mehdidotesk73/3d-print-designs/src/dog_bag_dispenser/stl/dispenser_assembly.stl

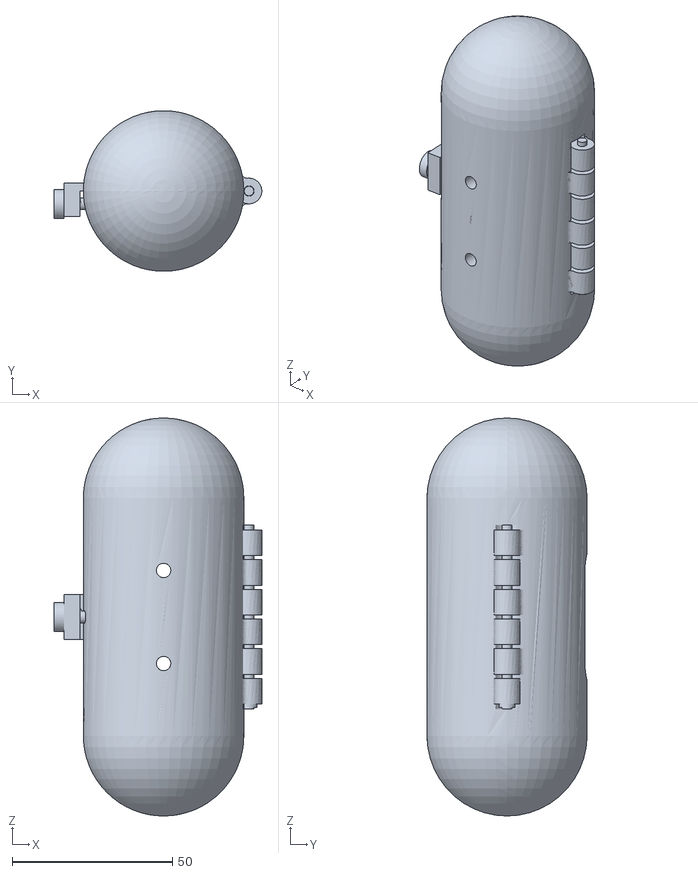
[picture p1: CAD file, 2026-09-21]
src/dog_bag_dispenser/stl/dispenser_assembly.stl
64.7 x 50.0 x 124.0
