mehdidotesk73/3d-print-designs/src/dog_bag_dispenser/stl/hinge_pin.stl

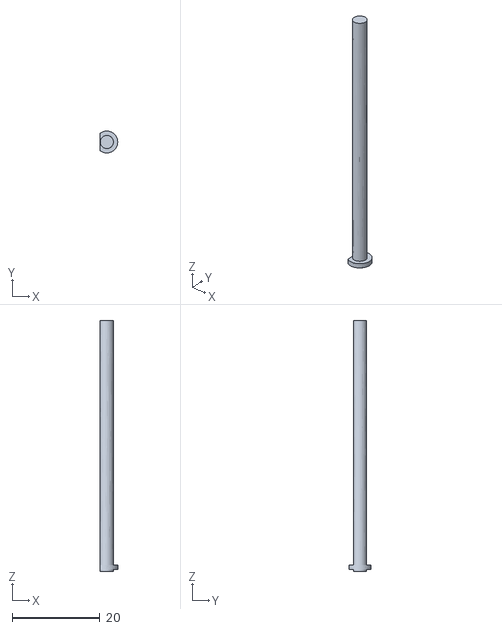
[picture p2: CAD file, 2026-09-21]
src/dog_bag_dispenser/stl/hinge_pin.stl
4.00 x 4.99 x 57.2
