mehdidotesk73/3d-print-designs/src/dog_bag_dispenser/stl/canister_front.stl

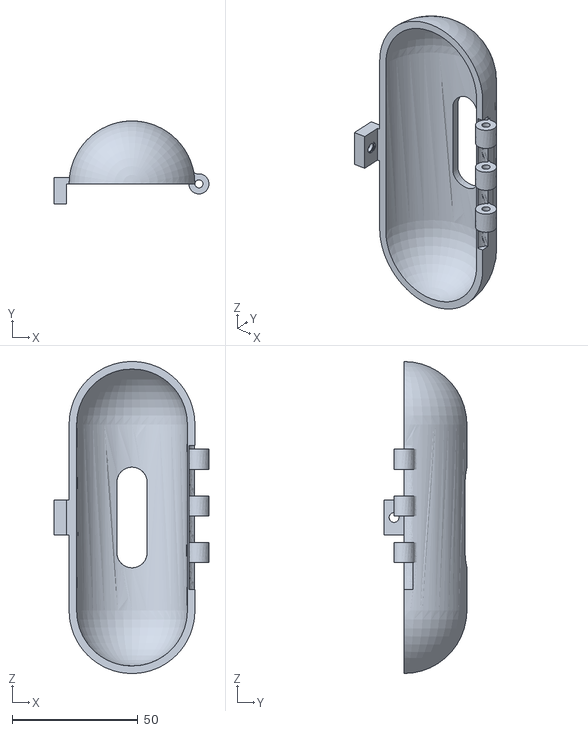
[picture p3: CAD file, 2026-09-21]
src/dog_bag_dispenser/stl/canister_front.stl
61.6 x 33.0 x 124.0
