mehdidotesk73/3d-print-designs/src/dog_bag_dispenser/stl/canister_back.stl

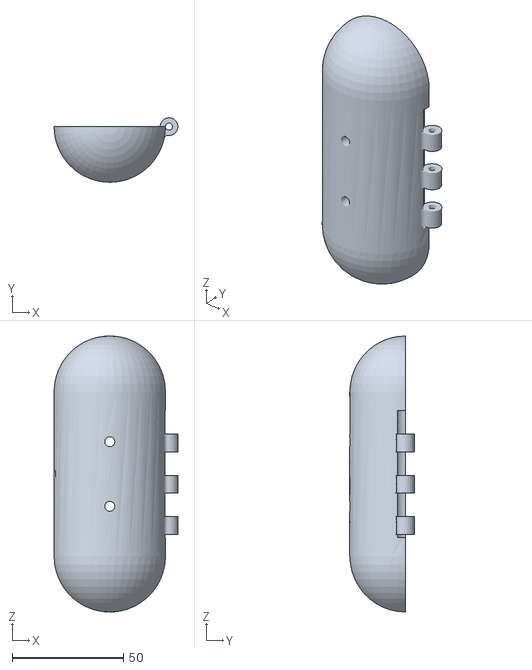
[picture p4: CAD file, 2026-09-21]
src/dog_bag_dispenser/stl/canister_back.stl
55.6 x 29.0 x 124.0
