mehdidotesk73/3d-print-designs/src/dog_bag_dispenser/stl/closing_screw.stl

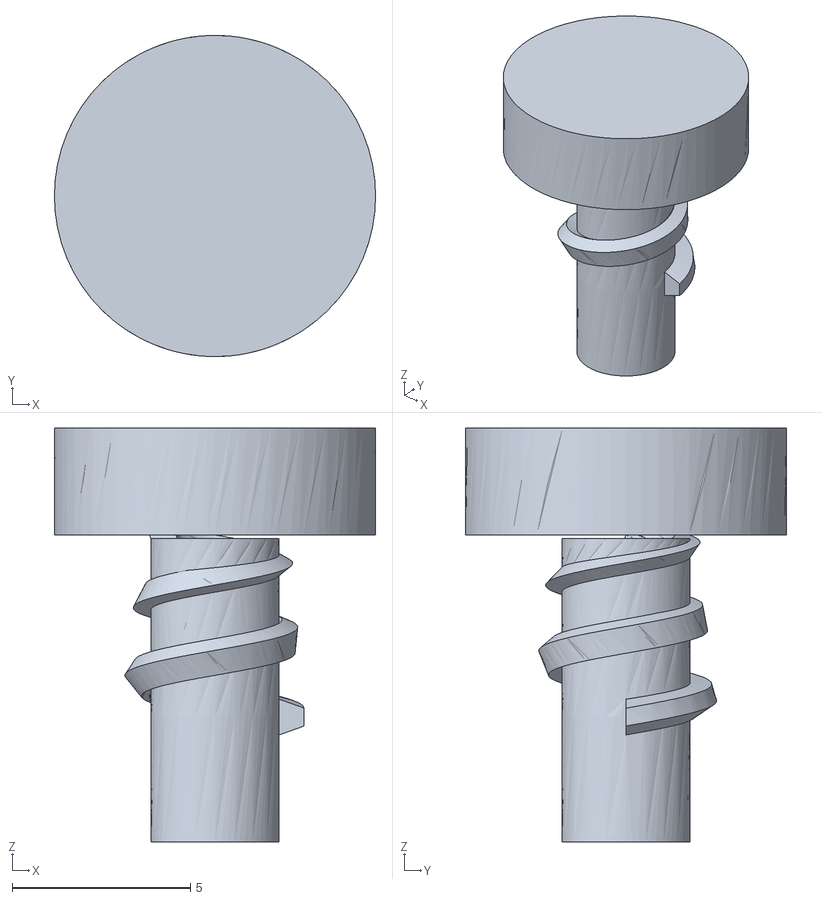
[picture p5: CAD file, 2026-09-21]
src/dog_bag_dispenser/stl/closing_screw.stl
9.00 x 9.00 x 11.6
