mehdidotesk73/3d-print-designs/(commit log)

2026-09-19 Add text-to-cad skills via npx skills
    Installs 11 skills from earthtojake/text-to-cad (bambu-labs, cad,
    cad-viewer, dfam-check, dxf, gcode, sdf, sendcutsend, srdf,
    step-parts, urdf) into .agents/skills with symlinks under
    .claude/skills, tracked by skills-lock.json.
    Claude-Session: https://claude.ai/code/session_011ZADNffntos3vzeQ4KcCR3
2026-09-19 Add dog poop-bag dispenser CAD model
    Two-piece clamshell canister (build123d/cadgen): a back half that
    mounts directly to a wall with two screws, and a front half that
    hinges open on interleaved printed knuckles and snap-latches shut,
    with a dispensing slit. Ø70mm ID / Ø76mm OD / 45mm long, sized for a
    standard single bag roll.
    Geometry checks (checks/check_dispenser.py) verify clean topology and
    zero interference between back/front/pin in the closed position.
    STEP/STL outputs are reproducible via `python src/dispenser_assembly.py`
    and gitignored accordingly.
    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
2026-09-19 Correct dispenser proportions and add hemispherical dome caps
    Swap the roll fit: cavity ID now matches the roll's diameter (40mm +
    clearance) and the cylindrical length now matches the roll's length
    (70mm + clearance), instead of the reverse. Overall shape changes from
    a short wide drum to a narrow capsule.
    Each half also unions a quarter-sphere dome onto both its ends, so the
    closed assembly's ends read as a true hemisphere and the cavity is
    fully sealed (previously open-ended).
    Fixes two interference bugs the dome caps and a corrected checks
    script surfaced: the hinge pin overhung into the now-solid dome
    material, and the small gaps between interleaved hinge knuckles had no
    pin clearance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
2026-09-19 Hollow the dome caps and rebuild the hinge as a placemaker channel
    Dome caps were solid quarter-spheres, sealing the cavity but plugging
    it with material; they're now hollow shells (outer sphere minus inner
    sphere, same R_IN/R_OUT as the main shell) so the capsule stays a
    constant wall thickness all the way to the tips.
    Rebuilt the hinge construction per a cleaner algorithm: a single
    "placemaker" channel at knuckle diameter is subtracted from both
    leaves across the whole hinge span first, so every point along the
    edge -- knuckle or gap -- starts out equally clear. Each leaf's
    alternating knuckle segments are then added back as solid bosses, and
    one continuous pin bore runs the full span thr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
2026-09-19 Move the hinge to an external tangent pivot, add a hook latch
    Hinge: the pivot axis was centered on the parting edge, half-embedded
    in each leaf's own wall. Once the dome caps sealed both tube ends this
    left the pin bore fully enclosed with no opening to slide the pin in
    from, and it also made each leaf's body sweep back through the pin's
    own space while swinging. Move the axis external and tangent to the
    tube's OD instead (a small deliberate overlap, not exact tangency,
    which OCCT can't fillet) so the knuckle bumps sit outside the tube's
    own wall material entirely -- the bore now opens to free air just past
    both ends of the knuckle row, and neither leaf's body ever sweeps back
    across the pi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
2026-09-19 Fix half-cut hinge knuckles; make the hook latch catch more prominent
    The tangent hinge rebuild clipped each knuckle's ENTIRE cross-section
    (annulus + knuckle bump) to its owning leaf's half-plane, slicing the
    knuckle bump itself into a "C" shape instead of leaving it round --
    visible in the viewer and confirmed by the reporter's screenshots.
    Fixed by clipping only the annulus portion to the leaf's own half
    (matching half_shell()); the knuckle bump itself stays a full,
    unclipped circle, like a real hinge barrel. That reintroduces a small
    overlap into the other leaf's territory on the knuckle's far side
    (same overlap this leaf's own side needs to fuse against, just
    unfiltered) -- a first att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
2026-09-19 Trim hinge knuckle far side to eliminate cross-leaf overlap
    Previously each knuckle's far side (facing the other leaf) bulged past
    R_OUT into the other leaf's territory by design, relying on
    hinge_clearance() to cut a compensating hole in the other leaf. Per
    user feedback that filleting/interference issues traced back to this,
    trim the far-side arc so it never dips inside R_OUT in the first
    place -- the knuckle stays full round from outside, but no longer
    needs a clearance cut on its neighbor. Confirmed via checks and a
    direct overlap_volume probe that hinge_clearance() is now a true
    no-op, so it (and the now-unused KNUCKLE_CLEARANCE_R) were removed.
    All checks in checks/check_dispenser.py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
2026-09-19 Rebuild hinge as a generic edge+normal knuckle construction
    Replace the ad hoc 2D-sketch-profile hinge (union/trim/fillet done on a
    cross-section before extrusion) with a generic, explicitly-staged
    construction on real 3D solids:
    1. Generation: slice the hinge's full-length bulk cylinder into knuckle
    segments (still via the existing alternating packer/gap logic),
    pierce all of them with the continuous pin bore.
    2. Placement: each knuckle's axis starts on the hinge edge (the tube's
    own parting line at X=R_OUT) and moves along the hinge normal
    (outward radial) by the pin bore radius -- HINGE_AXIS_X = R_OUT +
    PIN_R, replacing the old R_OUT + KNUCKLE_R - HINGE_OVERLAP tangent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
2026-09-19 Cut the whole hinge envelope, not just the other leaf's segments
    The previous hinge_clearance() only notched the OTHER leaf's specific
    knuckle Z-segments, leaving the small gaps between segments (owned by
    neither leaf) as plain, un-notched wall -- visible as leftover material
    sticking out right next to the cleanly filleted knuckles (reported with
    screenshots showing exactly this on both canister halves).
    Replace it with hinge_envelope_cut(): a single continuous cylinder
    spanning the hinge's whole Z range at the knuckle radius, subtracted
    from a leaf's wall minus its own already-built segments. This clears
    the gaps and the other leaf's territory uniformly.
    This has to run AFTER the leaf's o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
2026-09-20 Replace the cantilever hook latch with a rigid pivoting lever
    The old hook had to rely on flex at its own arm to both engage and
    release during the closing/opening swing about a fixed pivot. Replace
    it with a fully rigid pivoting lever -- a separate small part, pinned
    to the back via its own mini hinge-style pivot -- that hooks over a
    static catch lip on the front. A second, independently-actuated degree
    of freedom sidesteps the flex requirement entirely instead of working
    around it.
    Generalized the hinge's own knuckle/fillet machinery into a reusable
    module (knuckle_row, knuckle_envelope_cut, reinforce_seam,
    _seam_intersection) so the latch's pivot -- a smaller-radius version of
    the same e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
2026-09-20 Replace the pivoting lever latch with a ridge+tongue+screw closure
    The lever latch (its own separate part, pivot pin, and interleaved
    knuckle row) was more complex than the dispenser needed. Replace it
    with the simplest mechanism yet: a single threaded screw.
    Back's closing edge gets a raised, solid ridge (latch_ridge()) --
    a hard barrier, not threaded. Front's closing edge gets a tongue
    (latch_tongue()) reaching out over it, with a self-tapping pilot hole
    undersized against the screw's own thread. Driving the screw down
    through the tongue presses its tip toward the ridge until it's
    physically blocked; once seated, the screw is a rigid strut between
    front and back -- pulling front open woul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
2026-09-20 Drop the latch's ridge; screw tip now rests in a plain bore in back's wall
    The user noticed that with the ridge height set to zero (and the tab
    adjusted accordingly), the closing design still works -- the ridge was
    redundant. Back's own wall thickness already provides enough depth to
    register the screw's tip and resist tangential motion at the latch edge
    as front tries to swing open about the main hinge; the ridge did the same
    restraint job with extra material and geometry, for no extra strength.
    Renamed the front's closing feature from "tongue" to "tab" per the user's
    own terminology, and its pilot hole to "screw fastening hole". Back's
    closing edge now just gets a plain, oversized, unthre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
2026-09-20 Add a repo-hosted STL viewer with per-part downloads
    index.html at the repo root is now a self-contained, git-tracked
    alternative to the Claude Artifact preview: clone the repo, open the file
    directly in a browser (no local server needed), and view or download each
    part's .stl. Each part card gets its own "Download .stl" link, and the
    main toolbar has a download button for whichever part is currently shown.
    Verified with headless Chromium against a file:// URL that a plain
    fetch() of a local file is blocked (no CORS for that scheme) but a
    <script src> load isn't, so the mesh data the 3D preview needs is
    embedded via src/stl/viewer_data.js (loaded as a script, generated as a
    JS object litera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
    [canister_back.stl, canister_front.stl, closing_screw.stl, dispenser_assembly.stl, hinge_pin.stl]
2026-09-20 Restructure into per-project folders; auto-discovering multi-project viewer
    Moves the dispenser's lib/, model scripts, README, and STL bundle into
    src/dog_bag_dispenser/ -- the first of what will be several projects in
    this repo, each with its own lib/, script files, and generated STL under
    its own folder rather than sharing one flat src/. Model scripts' STEP
    outputs now nest under STEP/dog_bag_dispenser/ (mirroring the source
    path) instead of colliding at the STEP/ root with a future project's
    same-named parts.
    Each project gets a small build.py (using shared plumbing factored into
    the new scripts/project_build.py) that rebuilds its models and exports a
    fresh STL per part into its own stl/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
    [canister_back.stl, canister_front.stl, closing_screw.stl, dispenser_assembly.stl, hinge_pin.stl]
2026-09-21 Show a part subtab's full description only when it's selected
    Previously every subtab showed a 2-line, ellipsis-truncated description
    at all times. Per feedback, deselected subtabs now show just the part
    name, and the active one expands to its full, untruncated description
    (a little wider too, so a long one like the closing screw's doesn't get
    too tall) -- pure CSS, gated on the aria-pressed attribute the click
    handler already sets.
    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
2026-09-21 Switch the closing screw's thread to a flat-crest trapezoidal profile
    The previous thread swept a symmetric knife-edge triangle (a sharp point
    at both the crest and where it meets the root), which showed up in the
    rendered mesh as sparse, separated "fins" rather than a continuous
    thread -- the tooth base is only pitch/4 wide on each side, so there's a
    full 1mm gap of bare core between ridges at 2mm pitch. Functionally, a
    true point at 0.7mm depth is thinner than FDM reliably resolves (it just
    rounds over in practice), and a knife-edge root is a stress-concentration
    point right where the thread takes load while self-tapping into the
    tab's hole.
    Same pitch (2mm), same depth (0.7mm), same majo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
    [closing_screw.stl, dispenser_assembly.stl]
2026-09-21 Fix the screw's tip-to-thread step: derive SCREW_TIP_D from SCREW_MINOR_D
    The tip (the smooth pilot below the threads, seated in back's clearance
    bore) was a standalone constant at 3.2mm, while the thread's own core
    cylinder sits at SCREW_MINOR_D = 3.6mm -- a visible 0.2mm-per-side step
    right where the tip meets the thread. Asked to have the shaft read as one
    uniform diameter aside from the thread (and, separately, the head), so
    SCREW_TIP_D now just *is* SCREW_MINOR_D instead of its own magic number,
    guaranteeing they can't drift apart again if either constant changes
    later.
    BACK_BORE_D = SCREW_TIP_D + 0.4 derives from the tip diameter already, so
    it grew from 3.6mm to 4.0mm automatically,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
    [canister_back.stl, closing_screw.stl, dispenser_assembly.stl]
2026-09-21 Cut a real internal thread in the tab; add a hinge pin retention flange
    Latch: replaces the self-tapping fastening hole with a genuinely threaded
    one. Two printed plastic parts don't cut into each other the way a metal
    screw cuts into wood or sheet metal, and FDM's own layered, anisotropic
    strength makes that even less reliable -- so latch_tab_fastening_hole()
    now builds a THREAD-MAKER, an oversized copy of the real screw's own
    helix (same threaded_shank() function, same pitch/phase/handedness, with
    the shaft, thread crest, and crest width each independently grown by a
    THREADMAKER_*_CLEARANCE constant and unioned), and subtracts it from the
    tab. The result is a true internal thread with real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
    [canister_front.stl, closing_screw.stl, dispenser_assembly.stl, hinge_pin.stl]
2026-09-21 Cut the hinge pin's flange to a D-shape, tangent to the shaft
    The flange (added last round to stop the pin sliding through) was a
    plain circle, sized small enough on its worst (inward-facing) side to
    clear the dome cap's own curved shell nearby. Per the user's sketch,
    cutting the flange with a plane tangent to the shaft's own outer surface
    -- removing material only on the side facing the tube's central axis --
    leaves a "D" shape instead of a disc.
    Confirmed via a clarifying round that the flange never has to travel
    through the knuckle bore itself: the pin installs by bringing the two
    leaves together with their knuckles interleaved, then sliding it in
    plain-end first, so only the plain shaft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
    [dispenser_assembly.stl, hinge_pin.stl]
2026-09-21 Add a shared TIGHT/NORMAL/LOOSE clearance reference for future parts
    Real prints of the dog_bag_dispenser exposed two clearance problems: the
    hinge pin (0.1mm radial bore clearance) was tough to push through, and
    the tab's self-cut internal thread (0.15mm growth on the thread-maker)
    had no chance of accepting the screw at all. Rather than just bumping
    those two numbers in place, captures the underlying lesson as a named,
    reusable taxonomy any future project in this repo can pull from: TIGHT
    (a pin meant to stay put by friction), NORMAL (flat surfaces meant to
    slide deliberately, not wobble), and LOOSE (surfaces with real printed
    texture like helical threads, or parts needing loose/unguided r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
